sokol07/LaserShutterTester/(commit log)

2019-03-06 Add device photo and schematic
2020-10-03 Change ESP8266 to Arduino Uno, change photoresistor to photodiode, add schematic, add resources
